ToniA/arduino-fujitsu-awhpcontroller/(commit log)

2014-04-18 Initial air-to-water heatpump control for Arduino Duemilanove
2014-04-30 Raise the cooldown limit to 30.5, as 30 degrees is so low it causes the heatpump to run
2014-05-08 Describe the purpose of the relays in the README
2014-12-29 Require a sensible temperature reading. Do not turn the heating cable on when the heatpump is at idle
